QUT-Motorsport/QUTMS_Inverters/hardware/35_final_bottom.png

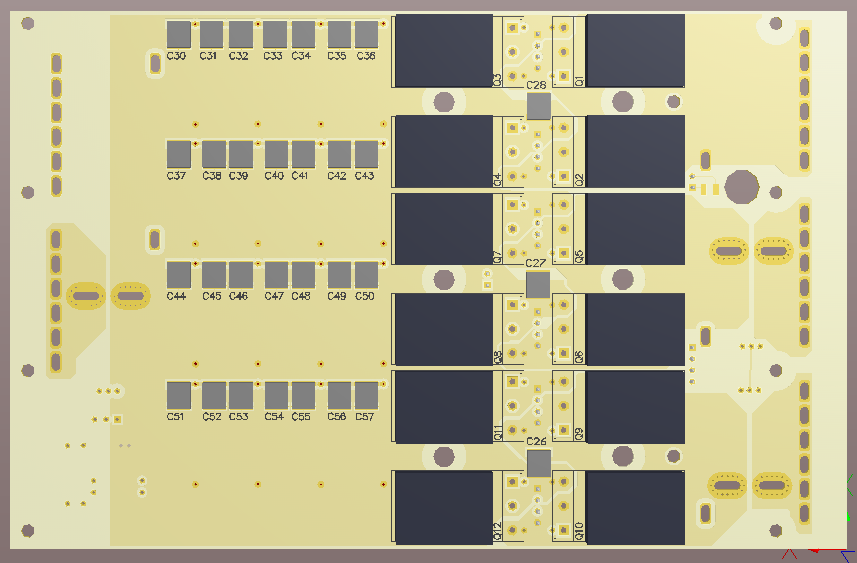
hardware/35_final_bottom.png
