QUT-Motorsport/QUTMS_Inverters/hardware/topView_bottomBoard.PNG

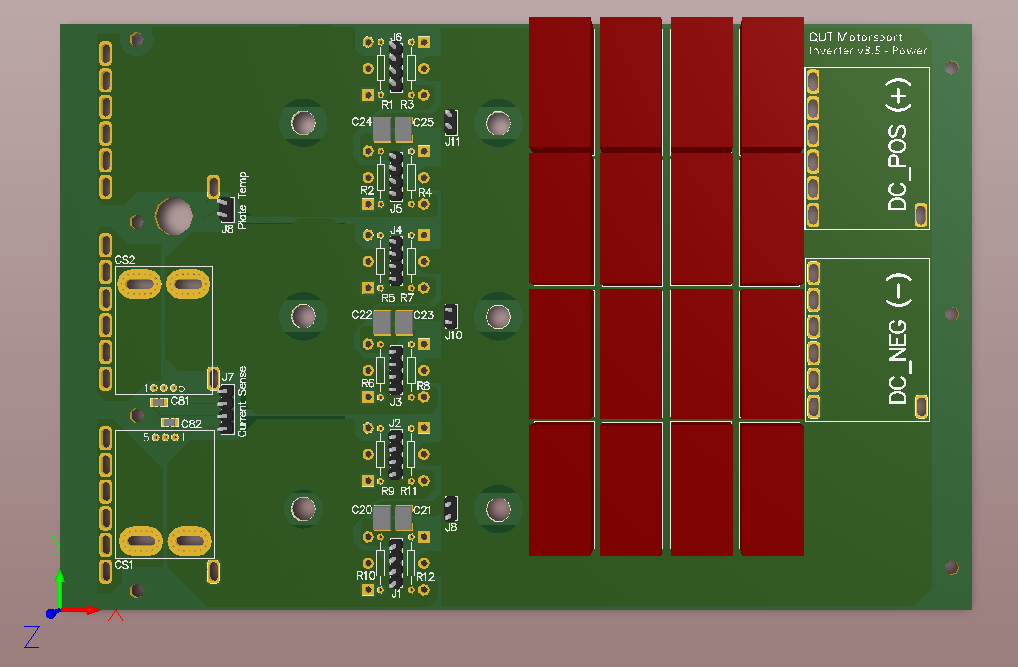
hardware/topView_bottomBoard.PNG
