QUT-Motorsport/QUTMS_Inverters/hardware/INVERTER_Logic_withCutout.pcbdoc.htm

Reporting Options

# File in Previous Format

Date | : | 9/08/2019
Time | : | 3:59:23 PM
Filename | : | C:\Users\Motorsports\Documents\git\QUTMS_Inverters\hardware\INVERTER_Logic_withCutout.pcbdoc

Version | Warning

This file was generated by an earlier version of the software
