QUT-Motorsport/QUTMS_Inverters/hardware/INVERTER_v35_BOTTOM_final.PcbDoc.htm

Reporting Options

# File in Previous Format

Date | : | 15/06/2019
Time | : | 12:15:06 PM
Filename | : | R:\Users\Jonn\Documents\git\qutms\QUTMS_Inverters\hardware\INVERTER_v35_BOTTOM_final.PcbDoc

Version | Warning

This file was generated by an earlier version of the software
