QUT-Motorsport/QUTMS_Inverters/hardware/INVERTER_Logic_noCutout.pcbdoc.htm

Reporting Options

# File in Previous Format

Date | : | 14/06/2019
Time | : | 9:55:11 PM
Filename | : | R:\Users\Jonn\Documents\git\qutms\QUTMS_Inverters\hardware\INVERTER_Logic_noCutout.pcbdoc

Version | Warning

This file was generated by an earlier version of the software
