QUT-Motorsport/QUTMS_Inverters/hardware/16se2_50886127_1662526_BEB802_FinalReport_A_Kellam_n8579407.pdf

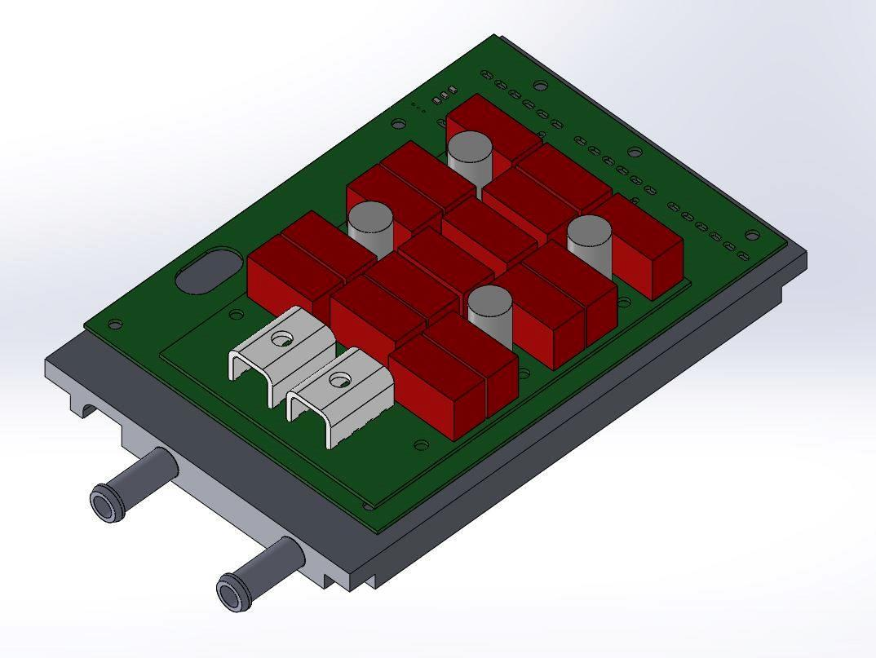
[picture p3: figure]

Anthony Kellam | BEB802 | November 4, 2016
Supervisor: Associate Professor Geoff Walker

# Formula SAE Motor Inverter

FINAL REPORT

### Executive Summary

In 2016, Queensland University of Technology is competing in Formula SAE with an ambitious electric vehicle. This project features four-wheel drive with independent in-hub motors, utilising a 15kW brushless DC motor in each wheel. With the unique packaging and communications requirements of the project, along with its extreme weight sensitivity, a new type of motor inverter was required to achieve the project’s goals.

The initial design challenges commenced with producing an extremely compact, water-cooled enclosure. With a low DC bus voltage of 90V resulting in peak currents of more than 150A, bespoke high-current PCB interconnects needed to be developed, along with a stacking multi-PCB layout to keep the inverter below the 1500 cm³. In conjunction with the mechanical design work, software was developed allowing the controller to run in constant speed or constant torque modes, whilst utilising the ultra-low latency CANbus based control protocol.

The project delivered an inverter design which allowed the vehicle to meet all its initial design goals. Further design work will be needed to improve the efficiency of the inverter thus allowing the performance of the vehicle to reach its ultimate limit.

### Contents

Executive Summary | 1
Table of Figures | 3
1.0 Introduction | 4
2.0 Project Objective | 5
3.0 Project Approach | 6
3.1 Design | 6
3.2 Testing | 7
4.0 Design Detail | 8
4.1 Design Foundation | 8
4.2 Switching stage | 8
4.3 microcontroller selection | 8
4.4 galvanic isolation | 9
4.5 gate drivers | 10
4.6 water cooling | 11
4.7 Software | 12
4.8 control and communications | 13
5.0 Analysis | 14
6.0 Results and Findings | 15
7.0 Conclusion | 17
7.1 meeting the specification | 17
7.2 knowledge contribution | 17
7.3 future work | 17
8.0 Appendix | 0
8.1 Gantt Chart | 0
8.2 Plettenberg Data Sheet | 0
8.3 Inverter schematic | 0

## Table of Figures

Figure 5 - Output (Blue), High Side Gate (Green) and current (Yellow) for inductive load - 4% D.C.

Figure 6 - - Output (Blue), High Side Gate (Green) and current (Yellow) for inductive load - 8%

## 1.0 Introduction

QUT Motorsport is a student engineering and business team, which sets about competing in the formula SAE event held in Melbourne each year. This competition centres around the concept, design, manufacture, assembly and testing of a vehicle conforming to the FSAE rules [1]. Ultimately, the team together with their vehicle will compete against teams from other Universities both from Australia and abroad.

The current vehicle in development is electric and features an all-wheel-drive system with one motor per wheel. Since each motor requires its own inverter, it follows that the project also requires four inverters. For several reasons including packaging constraints as well as EMI mitigation the decision was made to locate each inverter as close as practicable to its respective motor. It became apparent that it would be difficult to find a pre-existing solution on the market which would satisfy and so the team set about designing a unit to meet the specific requirements of the EV project.

The motors being used on the vehicle are a brushless DC unit, rated at 15kW with a maximum speed of 6000 rpm and peak torque of 30Nm [2]. The vehicle has a bus voltage of 90V nominal. Therefore, the current research topic is to design, prototype, build and verify a controller capable of meeting these specifications as well as the physical attributes which the vehicle’s overall design requires. These extra requirements include a target mass of below 3kg, water cooling and an enclosure envelope of approximately 200mm x 120mm x 60mm; below 1.5 litres’ volume.

This report represents the final submission on the project, detailing the current state of the design, along with an analysis of its current performance level as well as recommendations for future work which will further advance the design. Delays and other challenges are also discussed. Finally, the conclusion will cover what this project represents by way of knowledge contribution.

### 2.0 Project Objective

The final objective for the FSAE motor inverter project was finally defined as the design, construction and characterisation of a brushless DC motor inverter which would meet the following specifications:

- 10kW continuous, 20kW peak
- 70-120V
- 3kg maximum
- 200mm x 120mm x 60mm
- Sub 1.5 litre volume

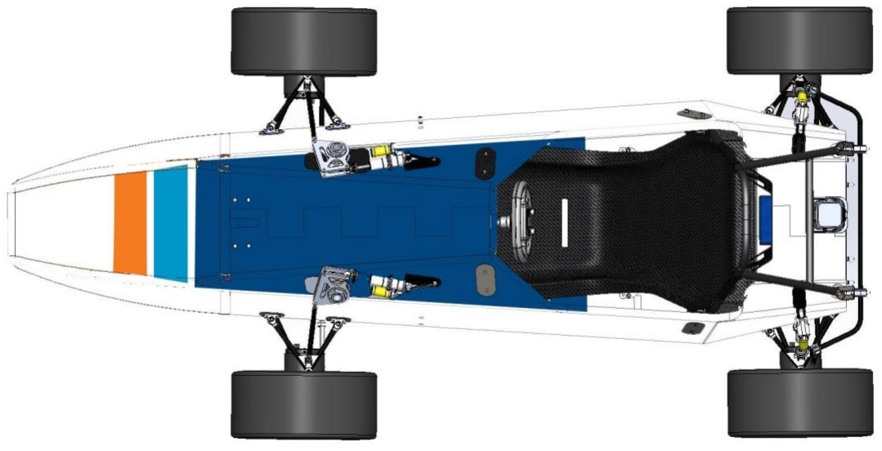
[picture p4: figure]

Figure 1 - QUT EV1 with motors visible in each upright

## 3.0 Project Approach

3.1 DESIGN

The approach used with the project was to iterate from an initial concept through successively higher power levels until a resulting version was realised which met the design specifications and goals. In the initial schematic design, several key devices and solutions were selected which achieved certain key aspects of rules compliances from the event organisers.

With the creation of a circuit design which met the project specifications a proof of concept version of the PCB was laid out in Altium Designer. The goals of this iteration were to provide a platform which would confirm certain design aspects as well allow the initial development of the control software eventually leading to a turning (unloaded) motor. This version of the design was to be rated at ~0.5kW with a target bus voltage of 30V.

Once the proof of concept version was constructed and development was ongoing, parallel work would be done on the mechanical design of a full power version of the inverter using essentially the same schematic design. Thermal design of the water cooling pate would be undertaken in conjunction with mechanical engineering students within the team.

Once a prototype full power inverter was constructed and operational, thorough testing of its performance could commence with a planned iteration to follow pending the outcome of this testing. As this stage was nearing completion, the design was to be documented with known operating areas, performance specifications, repair procedures and a complete description of the control messaging protocol and fault detection protocol.

With a full power design version then proven, manufacturing of the four to five units ultimately required for the vehicle project would be undertaken for final assembly, testing and installation into the vehicle.

3.2 TESTING

The testing plan would consist of validating the isolation and gate drive approach using the 0,5kW proof of concept version. This would require a library of helper functions set up to utilise the microcontroller’s capabilities. At this stage, the CAN protocol could be built up as required with each stage being tested thoroughly.

### 4.0 Design Detail

4.1 DESIGN FOUNDATION

It stands to reason that the design at its most basic level would be a triple half bridge converter controlled by an appropriate microcontroller. Due to the power levels of the vehicle’s motors, namely the relatively low voltage combined with moderate to high current, mosfet switches were selected as the most appropriate switching element type. These will be discussed below, along with the design choices in relation to microcontroller design, isolation strategies, current sensing as well as mechanical and software topics.

4.2 SWITCHING STAGE

As mentioned previously, mosfets were selected as the best fit for the operating conditions expected in the inverter design. A wide variety of devices from many vendors were collated and investigated. Ultimately mosfets from IXYS were selected, with part number IXFX170N20T.

4.3 MICROCONTROLLER SELECTION

The main aim with microcontroller selection was to keep the design compact, affordable and easy to develop. With these goals in mind the ATmega64M1 microcontroller from Atmel was selected. These MCUs feature an AVR core and feature some extra peripherals which are relatively uncommon in the 8-bit market segment. These features are what cemented the choice of MCU. The ATmega64M1 includes a 3phase motor control peripheral which feature triple half bridge control with complementary outputs, automatic dead time insertion and safety shutdown features. The other important peripheral included in this MCU is a comprehensive CAN controller which meant that all the microcontroller’s cores responsibilities could be undertaken with very few external components required.

4.4 GALVANIC ISOLATION

The FSAE rules mandate the complete galvanic isolation between the vehicles grounded low voltage (GLV) power system and the HV/tractive power system. This means that at some stage within the inverters themselves, an isolation boundary must be implemented. There are two typical locations for this boundary – either at the initial communications level meaning all the inverters’ logic and control would be on the HV side or between the logic elements and the gate drive. For this design the second option was selected for two reasons; powering the logic would allow certain measurements and status checks to be performed on the inverters with the vehicle not in a ready-to-drive (armed) state. This could potentially help with temperature and cooldown profiling. The second reason is one of power management. Due to aspects of the rules in regards to accumulator capacity, the project was limited to 24MJ of battery storage for the tractive system. By moving the logic power requirements to the GLV system this took further stress from the HV batteries which would result in a greater vehicle operating range.

With this design choice made, the actual hardware which would produce the isolation was investigated. Ultimately RF type digital isolators were chosen from Silicon Labs – the Si8660 and Si8663. These devices were chosen due to their predictability of operation with one or the other separation side de-powered. They are also extremely fast guaranteeing accurate gate drive timing. Lastly, their wide operating voltage with asymmetry meant that should logic changes be required into the future possibly requiring 3V3 rails, major design changes would not be needed.

4.5 GATE DRIVERS

From the multitude of gate drivers available on the market the most suitable was soon found to be the FAN73933 from Fairchild semiconductor. These integrated half-bridge drivers include a bootstrap system for the high side switches, programmable dead time to give some redundancy from the MCU and a very healthy gate drive capability which would be essential with the chosen IXYS mosfets.

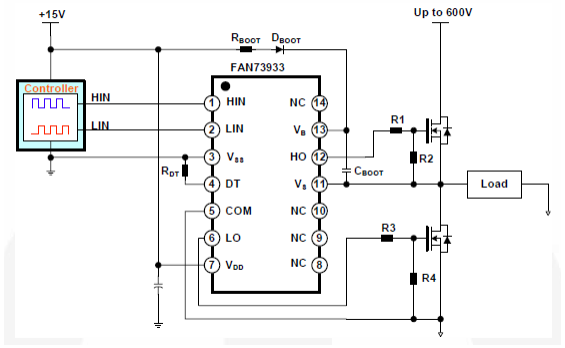
[picture p5: figure]

Figure 2 - FAN73933 typical application

4.6 WATER COOLING

A mechanical design concept was built up in conjunction with mechanical engineers from within the team. This was based on a 20mm 6061 Aluminium plate with machined water galleries and a sealing plate. The mosfet stage is bolted to the top of this plate with end plates and a main cover added thereafter.

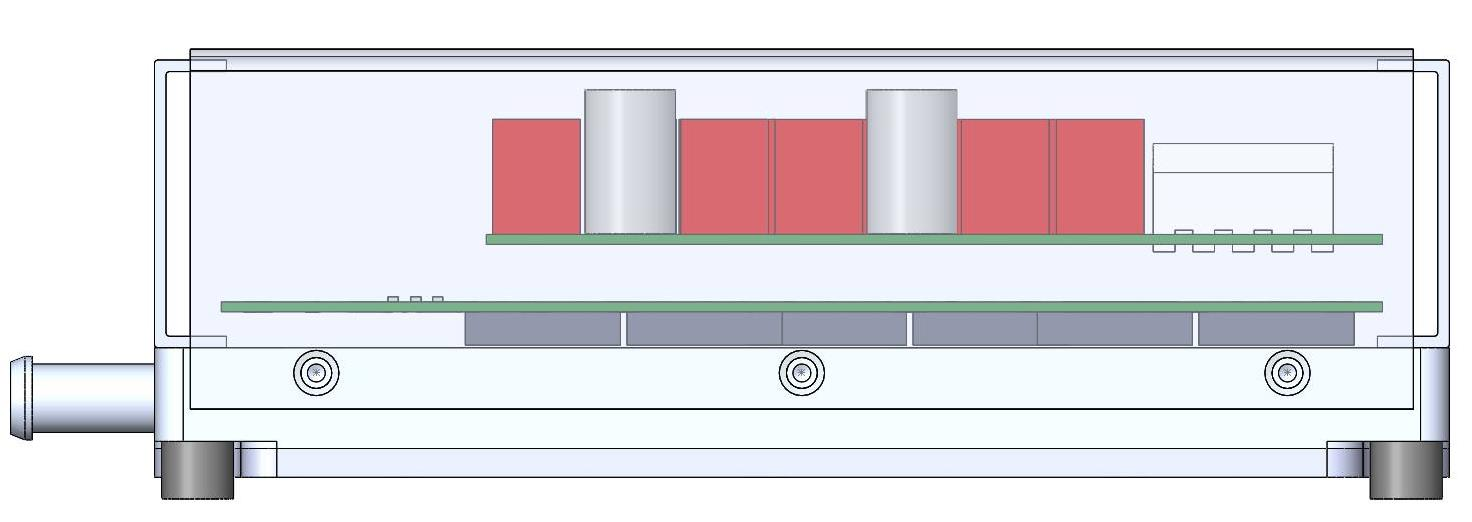
[picture p6: figure]

Figure 3 - Inverter thermal design detail

4.7 SOFTWARE

Two control methods are being implemented in the inverter – a speed command method and a torque command method. The speed mode utilises a control loop to maintain an RPM setpoint as commanded by the chassis controller or similar. This mode is mainly for testing and alternative applications. Achieving this mode required the addition of some background code using timers and hall state interrupts to constantly update an RPM measurement for the system’s use. This RPM can then also be reported back to the chassis controller to form part for the control strategy for its vehicle dynamics and safety systems.

The second control method, commanded torque, requires the integration of more of the sensors which have been included in the inverter’s design. Specifically, the current sensors available on two of the three phases need to be brought online for this mode to work successfully. Adding these sensors also allows for a critical fault mode to be detected being overcurrent or current faults.

CAN bus communications are at the centre of the projects system level integration. The tractive system has its own dedicated bus to allow for control with the lowest possible latency. Torque commands for each of the 4 motors are packaged in a single CAN packet which allows for even lower response delays. Whilst the fact that the inverters and the remaining control systems are being produced within the team means these protocols can be highly optimised, it also means there is a lot more software to develop. A lot of effort has been put into the tractive CAN protocol and this has been developed on the prototype inverter.

The last area where software work has been carried out in in the start-up code. This is the system which initially achieve motor rotation before any significant movement has occurred.

4.8 CONTROL AND COMMUNICATIONS

CANbus is used extensively in the vehicle and it is the main communications layer for the control of the inverters. A protocol was developed where the inverters could be addressed within a common CAN packet using flags to mark the intended recipient(s). The CAN protocol then allows enough data to embed four differing command values with a single packet giving an extremely high bandwidth real time torque request to all four inverters simultaneously. This system has been fully developed and tested on four nodes in the same configurations as the vehicles. It performs well and easily achieves a bandwidth in excess of 1kHz which far exceeds the requirements of any future torque vectoring scheme which may be utilised in the vehicle.

### 5.0 Analysis

Initially, the 0.5kW version was analysed for its software responsiveness and performance as well as the starting sequence for initial motor rotation. Following this a full power version was assembled with a temporary logic board repurposed from a concept version inverter.

The full power inverter was connected to a 47uH 100A air cored inductor which was created to closely match the inductance of a target motor winding. Some waveforms from the inverter follow:

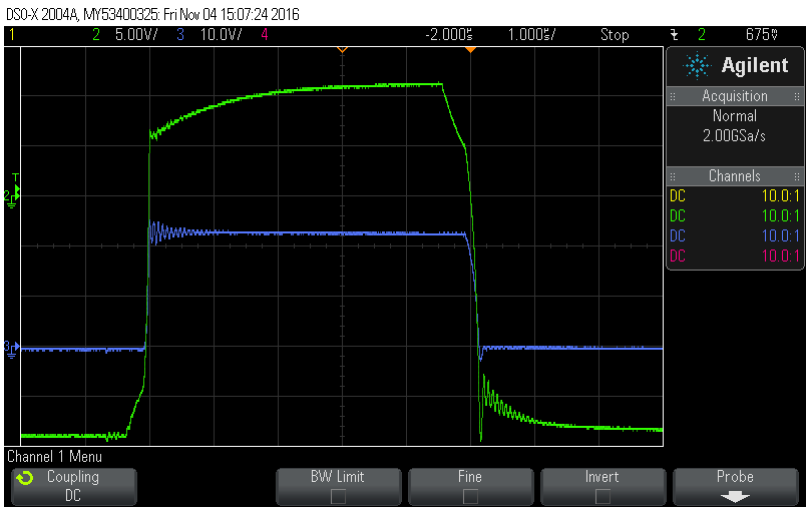
[picture p7: figure]

Figure 4 - Gate Drive (green) vs Output Voltage (Blue) 120W resistive load

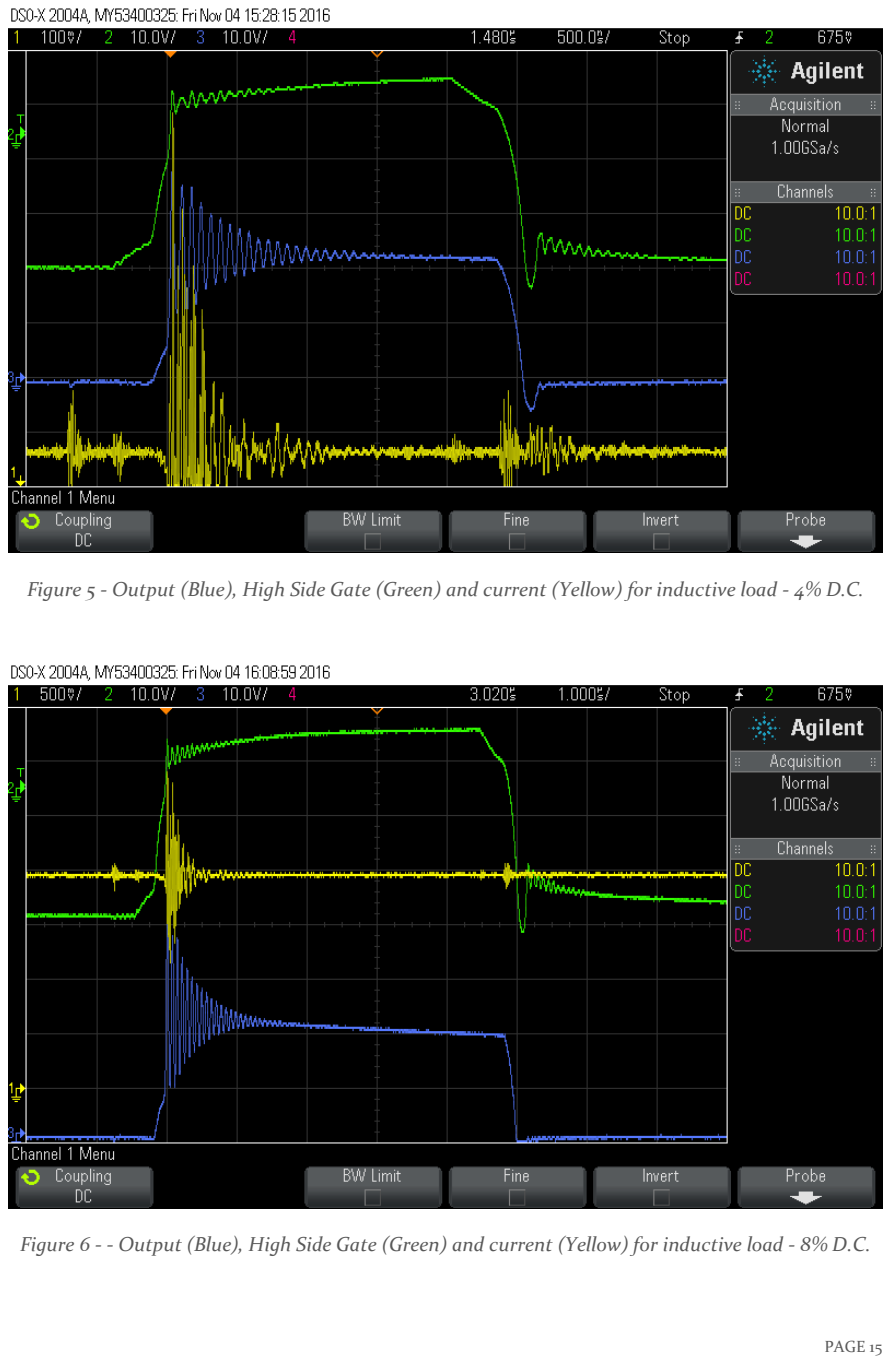
[picture p8: page 16]

Figure 5 - Output (Blue), High Side Gate (Green) and current (Yellow) for inductive load - 4% D.C.

Figure 6 - - Output (Blue), High Side Gate (Green) and current (Yellow) for inductive load - 8% D.C.

### 6.0 Results and Findings

The analysis has uncovered some gate drive issues which could potentially cause issues with high power operation into the inductive load. These are most probably caused by a sub-optimal gate drive layout due to the utilisation of the temporary logic board.

### 7.0 Conclusion

In conclusion, the formula SAE motor inverter project has reached a point where the design is suitable for manufacturing and installation in the vehicle.

7.1 MEETING THE SPECIFICATION

During high current testing the temperature levels have remained close to ambient. For this reason, it is apparent that the basic design specifications of the inverter have been met. The software system which has been implemented meets all of the requirements to allow the inverters to be controlled in the vehicle to meet the initial project goals.

7.2 KNOWLEDGE CONTRIBUTION

This design has produced a motor inverter specifically suited to performance vehicular applications where mass and volume/packaging are of extreme importance. The design gives the University’s FSAE team a great starting point for future motor control work inevitable leading into synchronous AC motors and more elaborate modulation techniques.

7.3 FUTURE WORK

Further testing would be of great benefit in further characterising the inverters’ performance. This would best be accomplished with “back to back” testing which would involve two of the motors being coupled together and driven into each other from a common power source.

Design improvements could also be undertaken to increase the ease of servicing on the inverter design to make any repairs more easily accomplished.

## 8.0 Appendix

8.1 GANTT CHART

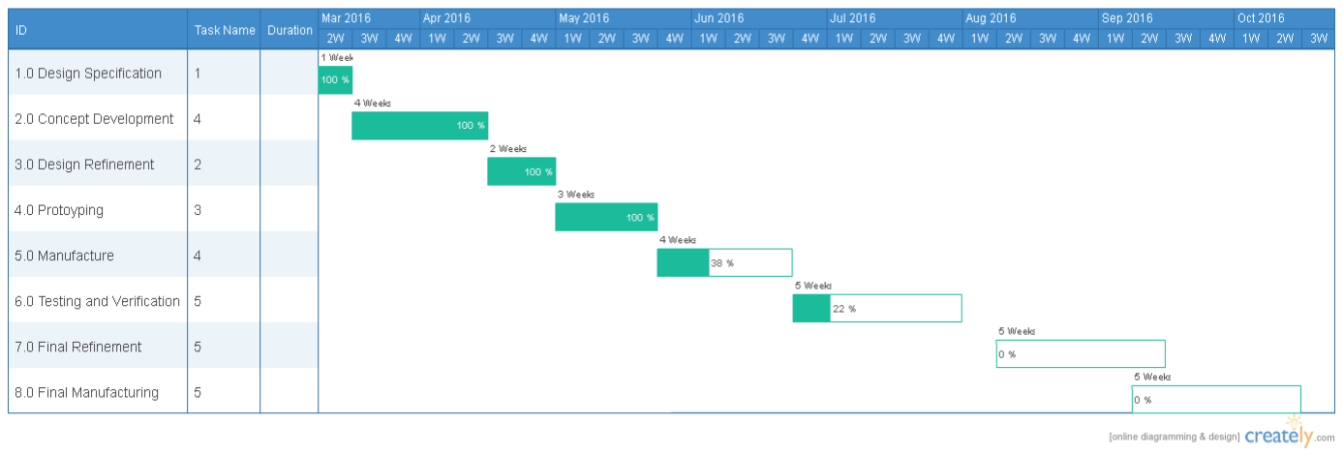
[picture p9: figure]

8.2 PLETTENBERG DATA SHEET

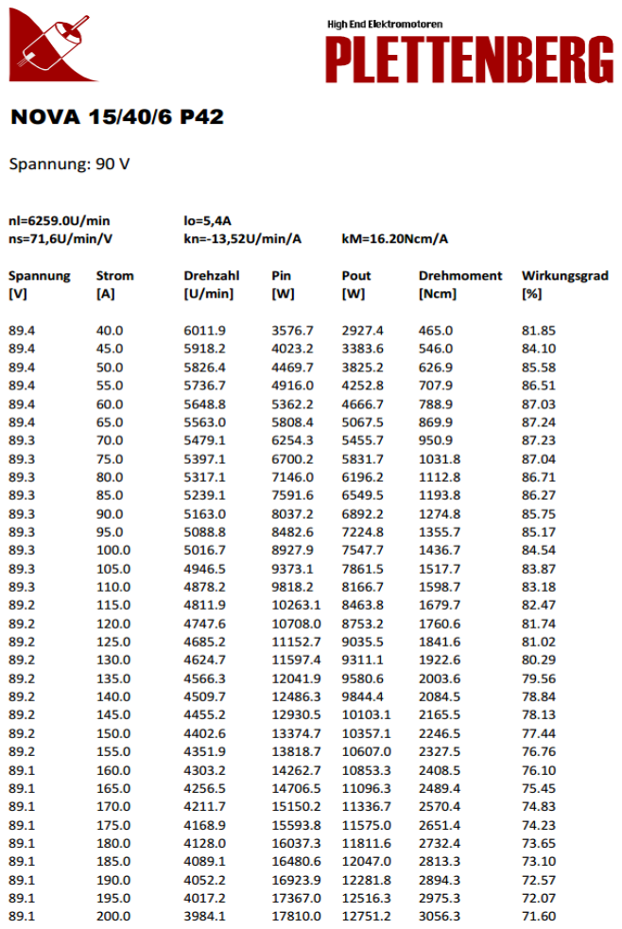
[picture p10: figure]
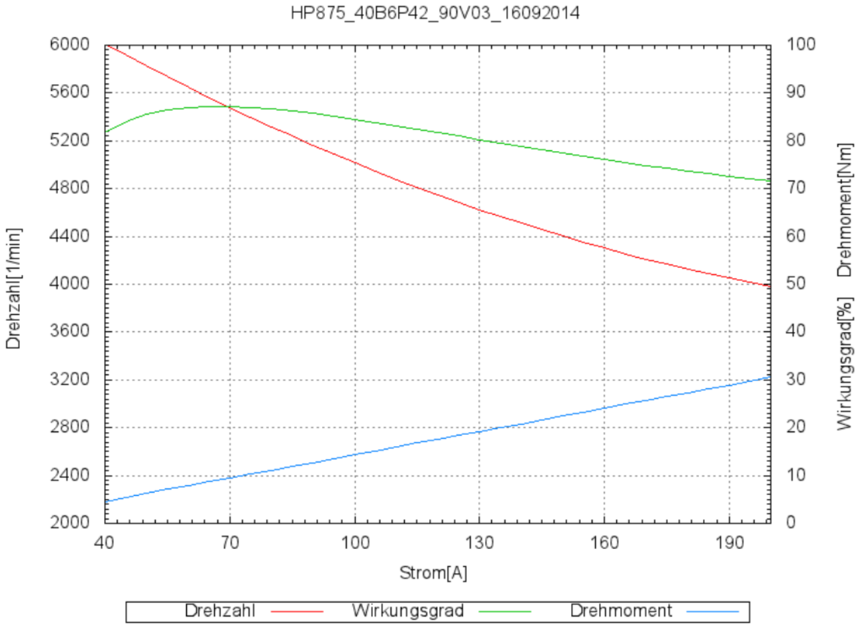
[picture p11: page 21]

8.3 INVERTER SCHEMATIC

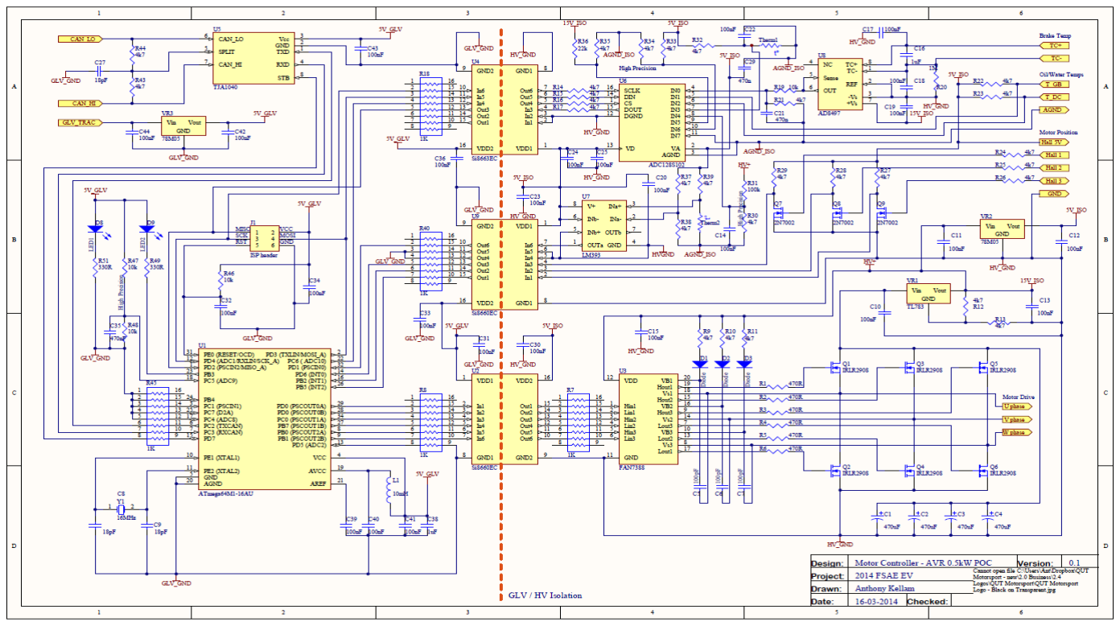
[picture p12: figure]

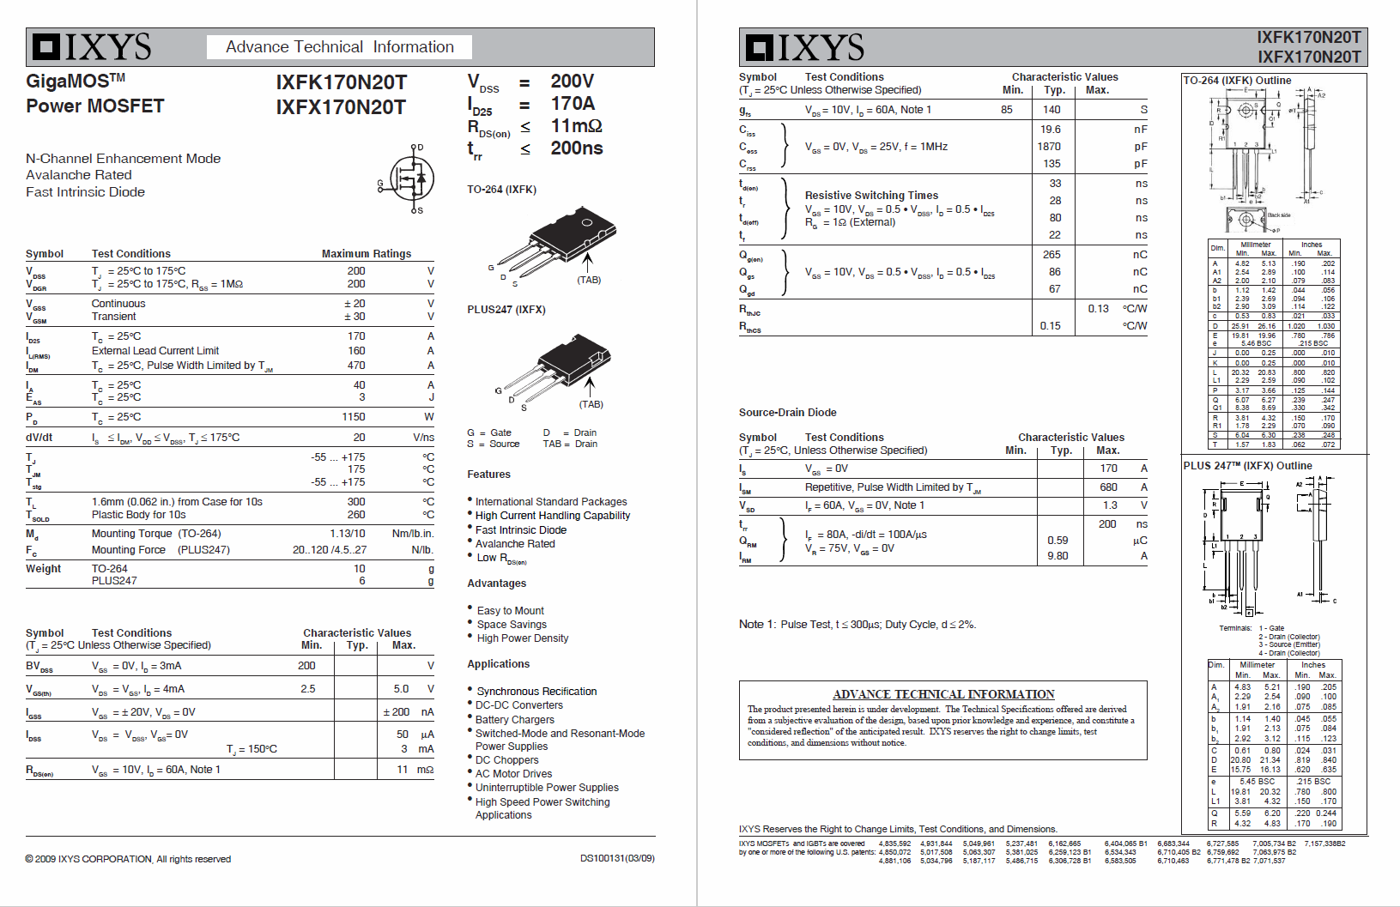
[picture p13: figure]

8.4 IXFX170N20T DATASHEET
