QUT-Motorsport/QUTMS_Inverters/hardware/35_final_top.png

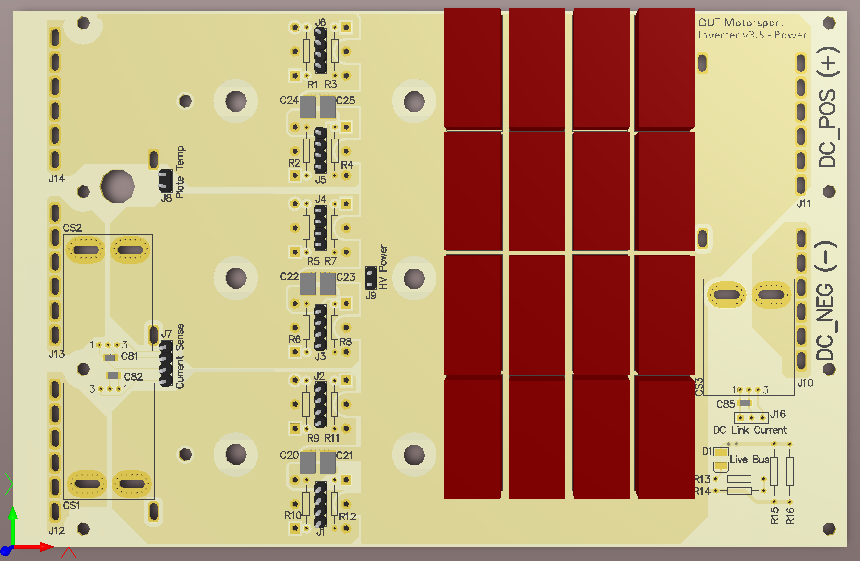
hardware/35_final_top.png
