QUT-Motorsport/QUTMS_Inverters/hardware/headers_v01.png

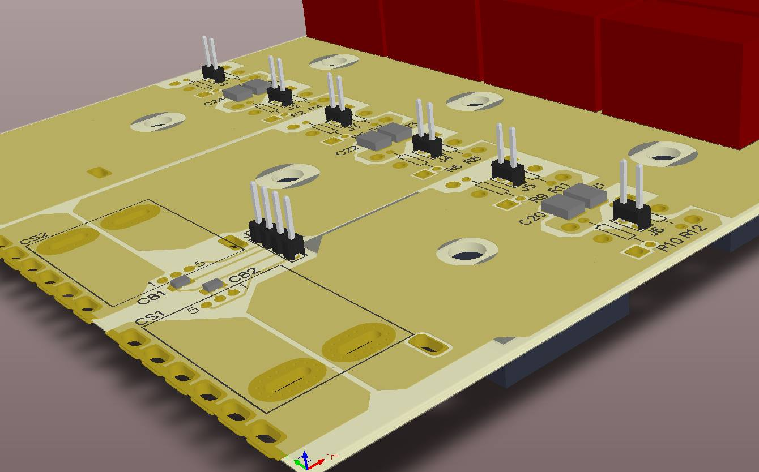
hardware/headers_v01.png
