QUT-Motorsport/QUTMS_Inverters/hardware/inverterSchematic.jpg

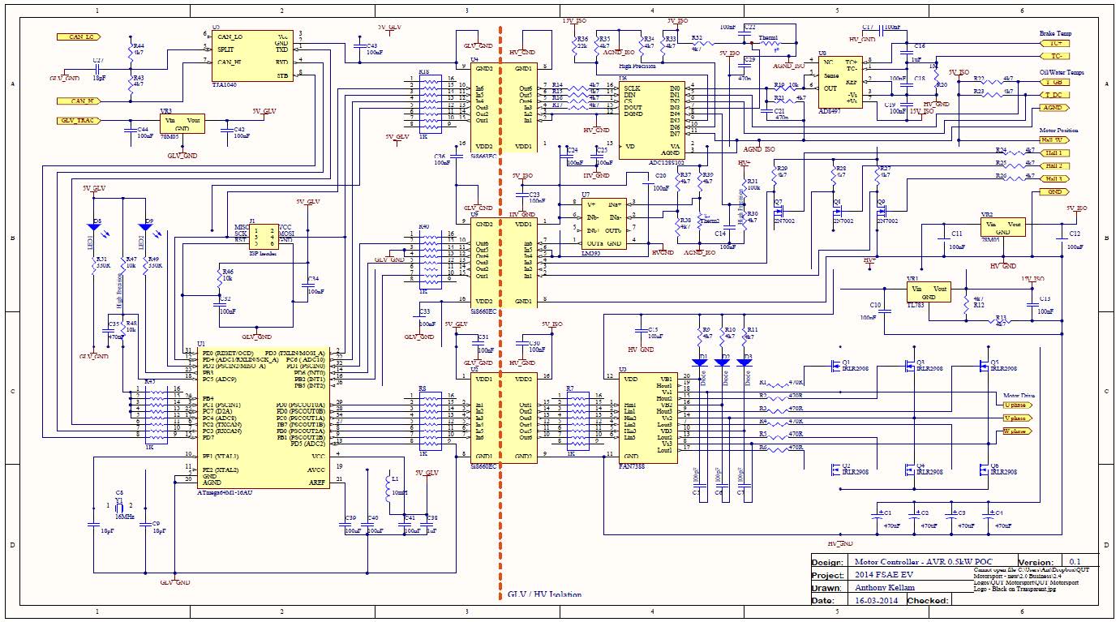
hardware/inverterSchematic.jpg
