QUT-Motorsport/QUTMS_Inverters/hardware/stackup.PNG

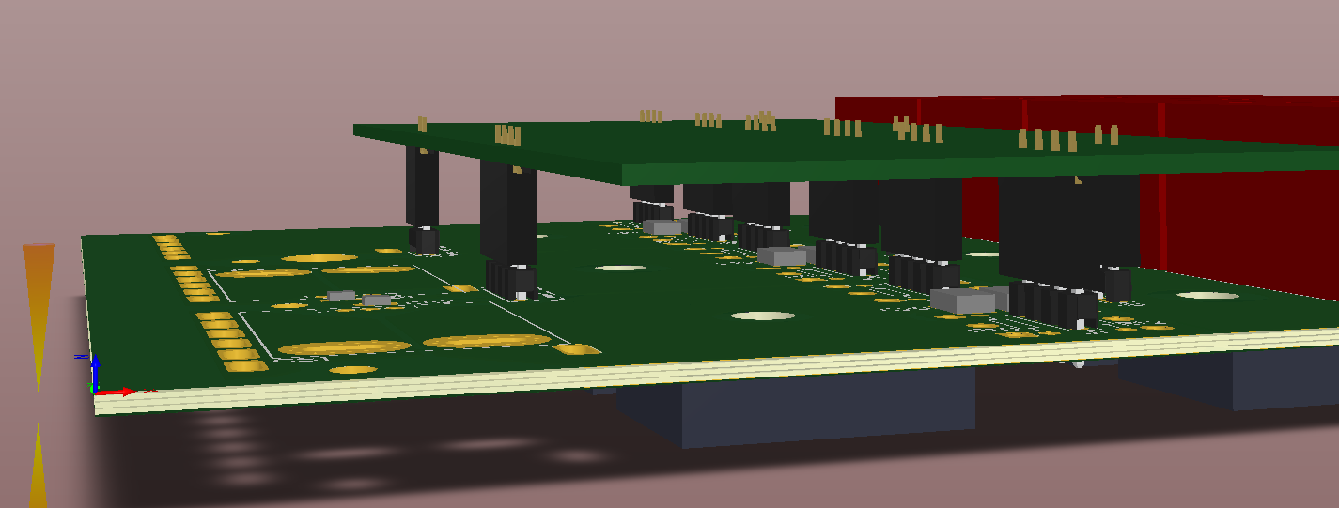
hardware/stackup.PNG
