QUT-Motorsport/QUTMS_Inverters/hardware/topView_bothBoards.PNG

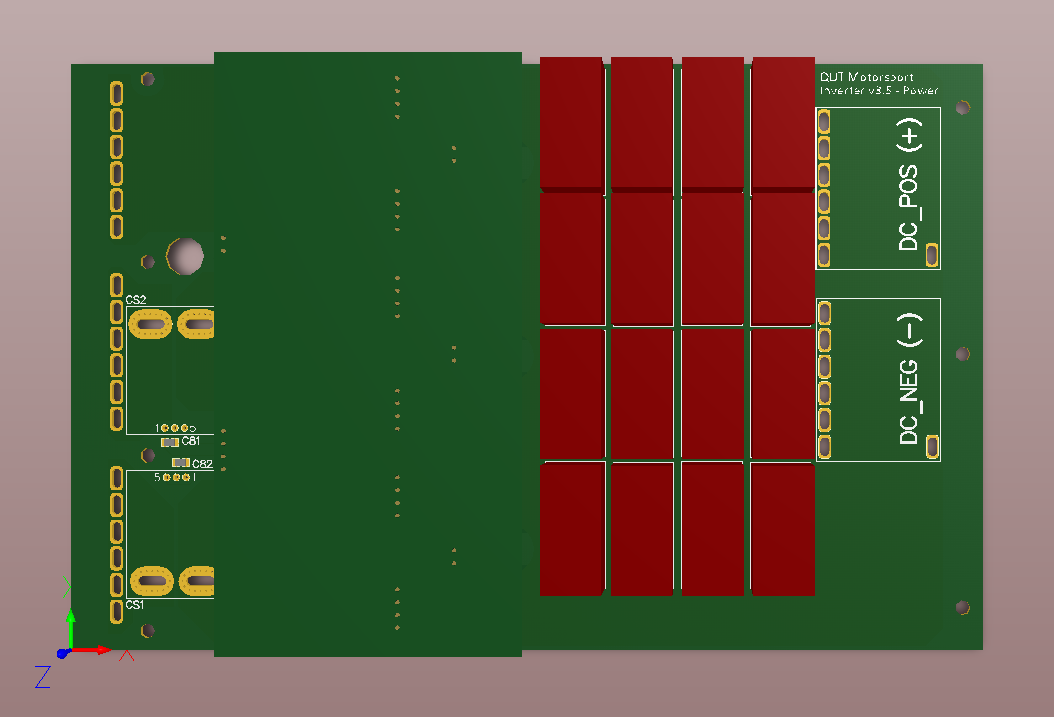
hardware/topView_bothBoards.PNG
