QUT-Motorsport/QUTMS_Inverters/software/64m1InverterFuseBits.PNG

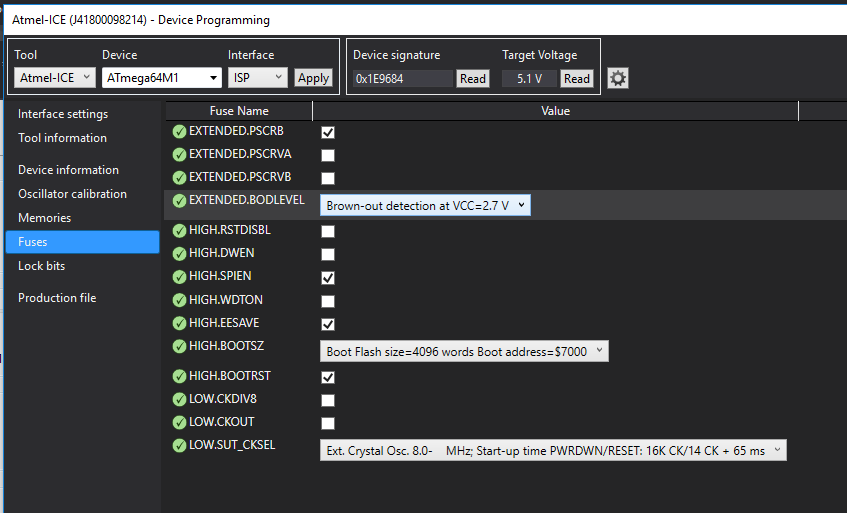
software/64m1InverterFuseBits.PNG
