QUT-Motorsport/QUTMS_Inverters/hardware/TERMINAL BLOCK.STEP

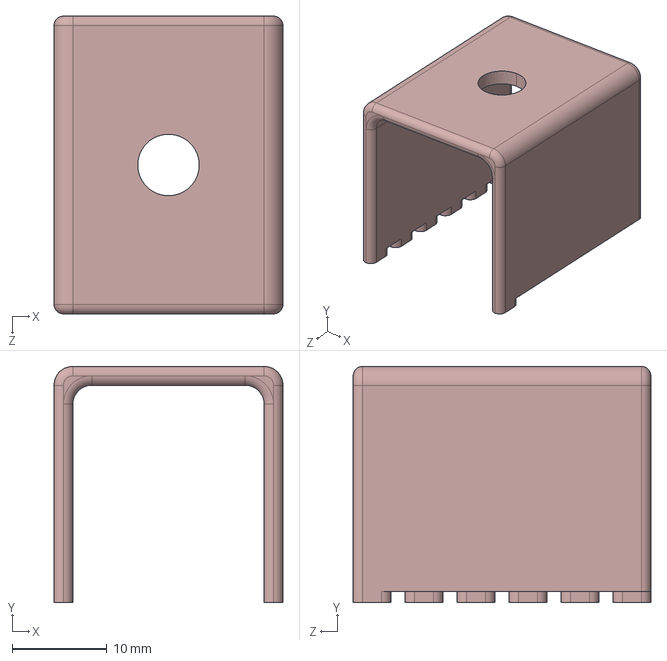
[picture p20: CAD file, 2019-06-15]
hardware/TERMINAL BLOCK.STEP
24.2 x 25.0 x 31.5 mm
