QUT-Motorsport/QUTMS_Inverters/hardware/INVERTER_v35_BOTTOM_final.step

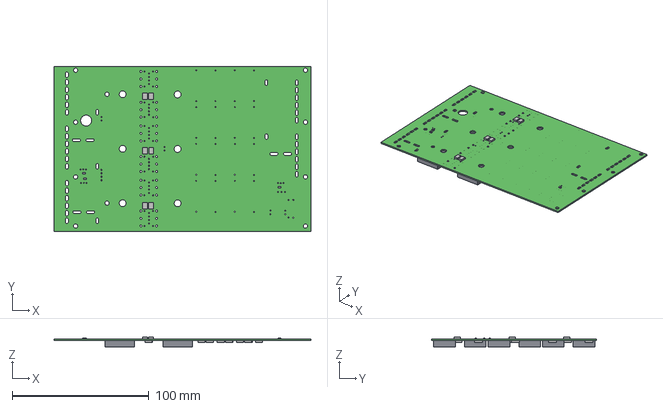
[picture p21: CAD file, 2019-06-15]
hardware/INVERTER_v35_BOTTOM_final.step
188.0 x 120.8 x 7.40 mm
