QUT-Motorsport/QUTMS_Inverters/(list of files, cad)

Other CAD files:
hardware/TERMINAL-BLOCK.igs
