QUT-Motorsport/QUTMS_Inverters/(threads)

Thread 3 (2020-01-19):

Current sensing using hall effect current sensors

liamkinne, 2020-01-19:
Using the ADC on the uC, read the three current sensors on the board.

cwljohnson, 2020-08-04:
yeah  look dont think this is an issue rn

liamkinne, 2020-08-07:
:(

Closed 2020-08-04.

Thread 4 (2020-01-19):

Fix inverter board missing component used for reading encoder

liamkinne, 2020-01-19:
One of the boards is missing a component near the motor encoder header. This is likely the cause of it not being able to read the encoder properly.

QUT-Motorsport-Admin, 2020-08-04:
yeah look dont think this is an issue rn

Closed 2020-08-04.
