QUT-Motorsport/QUTMS_Inverters/(list of files, drawings)

Other design files:
hardware/INVERTER_Logic_noCutout.pcbdoc
hardware/INVERTER_Logic_withCutout.pcbdoc
hardware/INVERTER_v35_BOTTOM_final.PcbDoc
hardware/INVERTER_v35_BOTTOM_final[1].PcbDoc
