QUT-Motorsport/QUTMS_Inverters/cc_merge2/cc_merge2/chassisUART.h

/**
 * @file chassisUART.h
 * @author Jonn Dillon
 * @date file creation 12/4/2018
 * @brief Defines and outlines all variables and definitions related to the UART communications process
 **/

#define F_CPU 16000000
#ifndef CHASSIS_UART_H
#define CHASSIS_UART_H

#include <stdlib.h>
#include <avr/io.h>
#include "main.h"

void uart_process_byte(char data);
void uart_parse_input(unsigned char* s);
void uart_parse_poke(unsigned char* s);
void uart_send_real_time_data (void);
void UART_formTestPacket(void);
void UART_sendPacket(uint8_t * outgoingString, uint8_t length);

#endif // CHASSIS_UART_H
