QUT-Motorsport/QUTMS_Inverters/(commit log)

2019-02-06 Timer registory setup done, Port disabled, if stsatment works, motor not init
2019-02-25 Anti-clock and clock wise code
    [MotorControl_2018.componentinfo.xml]
2019-02-25 Check for safety range and torque fast change
2019-02-25 renaming and verfying
    [MotorControl_2018.componentinfo.xml]
2019-03-03 Merging clock wise and anti clock wise code. cleaning up the repo. if failed, return before this commit
    [MotorControl_2018.componentinfo.xml]
2019-03-27 Zones to make sure mosfets are off before turning others on
    [MotorControl_2018.componentinfo.xml]
2019-05-01 Moved reply packet to the while loop. Disabilling timer 1 and timer 1 interrupt. retesting the motor command process
    [MotorControl_2018.componentinfo.xml]
2019-06-14 Added in all of the found Anthony thesis information. Specificly board information, exported gerbers, Anthony's thesis, various images, and the weird 0.5kW version
    [INVERTER_Logic_noCutout.pcbdoc, INVERTER_Logic_withCutout.pcbdoc, INVERTER_v35_BOTTOM_final.PcbDoc, INVERTER_v35_BOTTOM_final[1].PcbDoc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]
2019-06-15 Added terminal blocks and brought in line with rest of project files
    [INVERTER_Logic_noCutout.pcbdoc, INVERTER_v35_BOTTOM_final.PcbDoc, INVERTER_v35_BOTTOM_final.step, TERMINAL BLOCK.STEP, TERMINAL-BLOCK.igs]
2019-07-02 Reworked directiroy, started new code base
    [MotorControl_2018.componentinfo.xml]
2019-07-07 Recomutaed the engergise order for the smaller test motor
2019-07-11 Take two in uploading everything and renaming everything.Wrote new code to deal with different motors and directions
    [MotorControl_2018.componentinfo.xml]
2019-09-10 Fixed counter clockwise comutation order for plettenburgs, UNTESTED
    [main.c]
2019-09-12 Added the CCW order for the plettenburg motors from Anthony, as well as the fixed kickMotor function order for the CW. UNTESTED
    [main.c]
2019-09-12 Added raw comutation order file from anthony
    [PlettengburgMotorCombutation_CCW_AK_v4.xlsx]
2020-01-26 remove duplicate. file is also on the solidworks PDM now.
    [TERMINAL-BLOCK.igs]
2020-01-31 Sending voltage readings over CANbus
